todd-tracerlab/PTHSonde/Dashboard/tracerlab.png

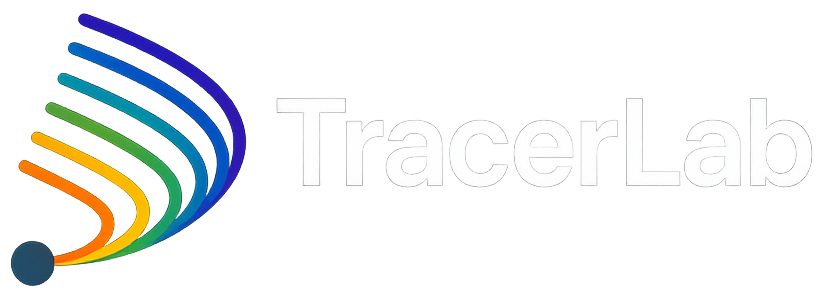
Dashboard/tracerlab.png
