todd-tracerlab/PTHSonde/Dashboard/truck.png

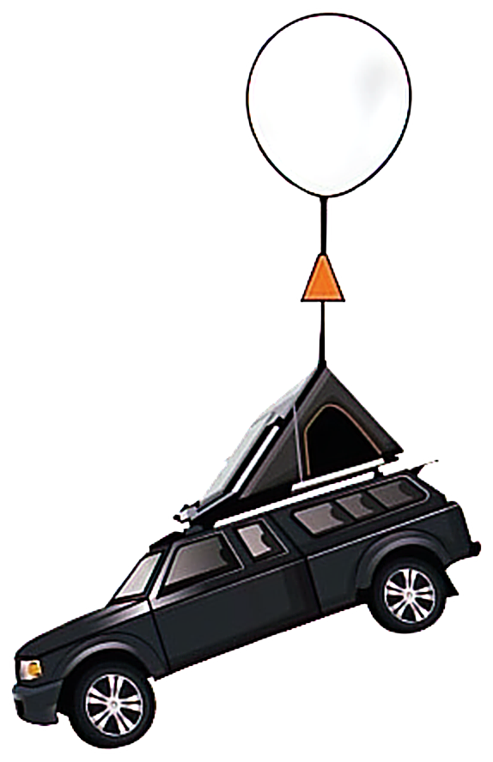
Dashboard/truck.png
