todd-tracerlab/PTHSonde/latax/3rd tie sonde to flight line.jpeg

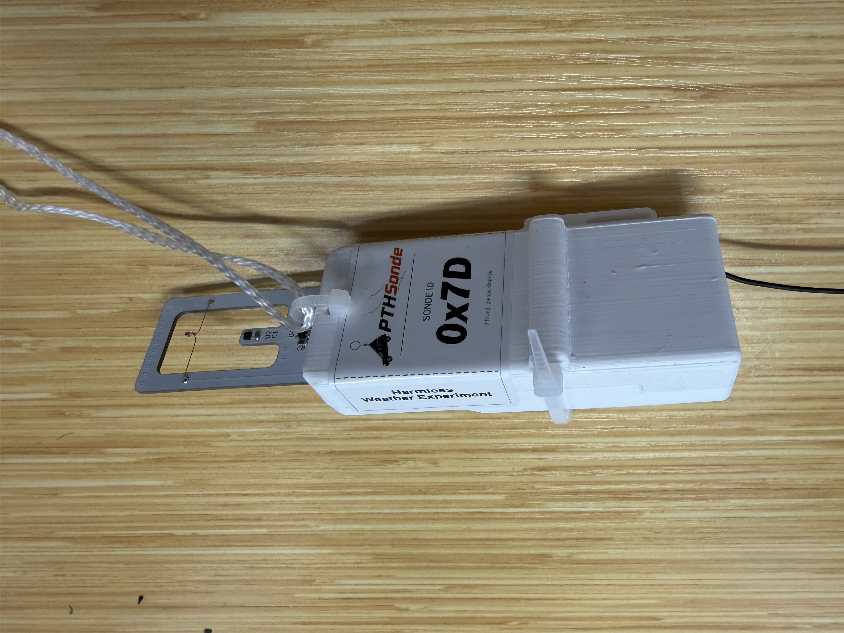
latax/3rd tie sonde to flight line.jpeg
