todd-tracerlab/PTHSonde/latax/first opening the battery door and inserting battery.jpeg

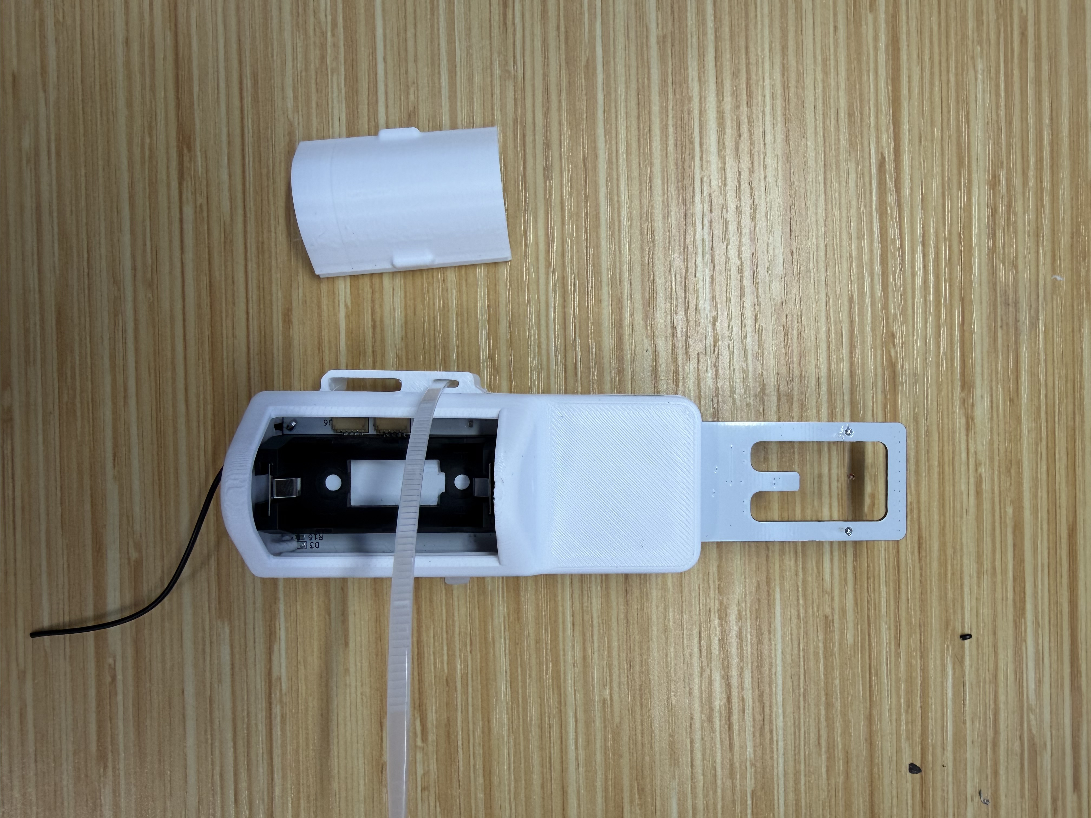
latax/first opening the battery door and inserting battery.jpeg
