todd-tracerlab/PTHSonde/latax/second zip tie the outer battery door closed.jpeg

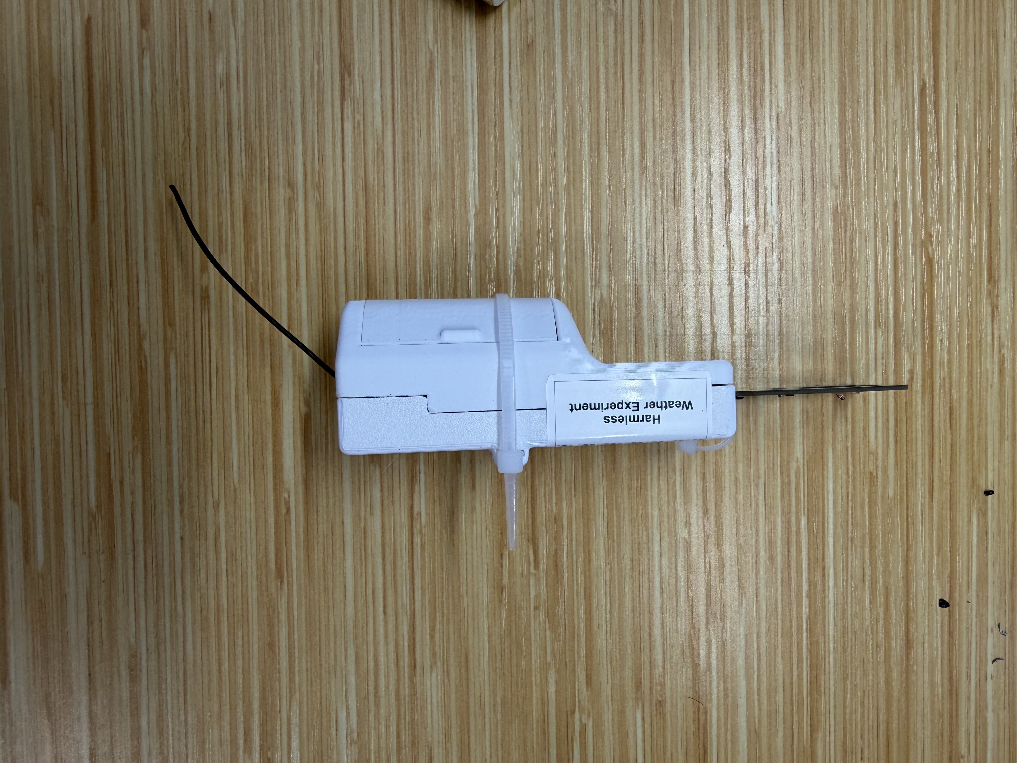
latax/second zip tie the outer battery door closed.jpeg
