todd-tracerlab/PTHSonde/(commit log)

2026-07-07 PTHSonde: firmware, dashboard, and processor + docs
    Complete open radiosonde telemetry system:
    - SondeTransmitter/ flight firmware (ESP32-C3): sensors, GPS, LoRa TX
    - GroundReceiver/ ground-station firmware: LoRa RX -> CSV over USB
    - Dashboard/ single-file HTML ground-station UI
    - processor/ pywebview app: Flask + serial + SHARPpy render pipeline
    - docs/ hardware map, firmware guide, dashboard guide
    GPS is held in L86 Balloon mode (80 km) with ACK verification; the sounding
    pipeline trims launch-pad thermal-soak so lifted indices are physical.
2026-07-09 Dashboard + processing refinements
    Dashboard:
    - Time Series moved into the right-panel toggle as a 2x3 grid
    (temp/dewpoint/wind on the left; ascent rate/altitude/humidity on the right;
    altitude shows both barometric and GPS traces)
    - Skew-T, hodograph and profiles are ascent-only (descent no longer plotted)
    - System Health: RSSI/SNR replotted as signal-vs-noise on one dBm axis (the gap
    IS the SNR); battery shows volts only; removed subtitle clutter; larger, higher-
    contrast axis labels
    - Map: plain gridded track map offline, real OSM tiles online, switching live
    without reopening; toasts on switch; GFS prediction warns when offline
    (also fixes the fallback <canvas> being stuck at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
    [sonde_server.py]
2026-07-09 Fix SHARPpy image: in-app zoom/pan lightbox instead of window.open(blob)
    Clicking the sounding did window.open(URL.createObjectURL(blob)), which WebView2
    can't navigate to -> Windows 'can't open this blob' popup in the packaged app, and
    there was no way to zoom into the panel's small text. Replaced with a DOM lightbox:
    click to open, scroll to zoom, drag to pan, double-click to fit, Esc/backdrop to close.
2026-07-09 Branding: TracerLab sidebar logo, PTHSonde wordmark, cropped truck, app icon
    - Add the TracerLab company logo pinned to the bottom of the sidebar (fills the
    previously-blank space; sits on a subtle dark card so it reads in both themes)
    - Replace the header text with a dedicated PTHSonde 'Ground Station' wordmark PNG
    - Crop the flying-truck art to content, upscale 2x + sharpen, and show it larger
    in a taller header (with a soft drop shadow for definition)
    - Use the flying-truck as the packaged app's Windows icon (PTHSonde.spec)
2026-07-09 Rebrand header + theme-aware top bar, orange accent, plot & UX improvements
    - New PTHSonde brand logo (truck + skew-T sounding) in the header; theme-aware
    top bar that swaps to light-ink logo + TracerLab in dark mode
    - TracerLab moved to the top-right; Light/Dark toggle moved into the top bar;
    default theme back to dark; top-bar elements spread across the width
    - Orange accent throughout (was blue); header 'Press Alt' (barometric)
    - Larger sidebar telemetry; ascent-only Skew-T; dual km altitude axis on the
    Skew-T and the three profile plots; larger/bolder axis labels + hPa/km captions
    - 'Import Past Flight' (renamed) no longer triggers the sonde-detected popup
    Processor:
    -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
    [sonde_server.py]
2026-07-10 SHARPpy panel: stamp launch date/UTC time + starting lat-lon
    Under the PTHSonde logo, caption the first solid GPS fix (real fix + >=5 sats,
    skipping cold-start glitches): date from the flight folder, UTC time from the
    GPS, and the starting lat/lon.
    [sonde_server.py]
2026-07-10 Firmware: proto v4 -- ground-derived wind, 0.1% RH, station ID, USB STATUS
    Telemetry protocol bumped 2 -> 4 (both boards must be reflashed together):
    - Wind off the air: drop wind speed + direction from the packet; the ground
    receiver now derives them from successive downlinked GPS fixes (velocity =
    d(pos)/dt, EMA-smoothed; met direction = travel bearing + 180). Fills the same
    speed_mps/wind_deg/v_wind CSV columns, so the recorder, data.csv, SHARPpy, and
    dashboard are unchanged. Packet 43 -> 39 bytes.
    - RH precision: sht_rh_x2 (uint8, 0.5%) -> sht_rh_x10 (uint16, 0.1%) to match
    the SHT41's actual repeatability. CSV already prints %.1f, no downstream change.
    - Ground-station ID: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
    [CsvOutput.cpp, GroundReceiver.ino, SondeTransmitter.ino, TelemetryPacket.h]
2026-07-12 GPS: bulletproof balloon mode + NaN stale position on fix loss
    The 2026-07-12 flight capped at ~11 km (the 10 km Normal-mode ceiling) even
    though the L86 ACKs balloon mode (fr=3) on the bench. Evidence: sats 15->0 in
    one step, GPS clock kept ticking (module alive, not cold, not reset-at-11km),
    never recovered. Per the Quectel Lx protocol spec, Balloon=80 km / all other
    modes=10 km, so the module was effectively in Normal mode in flight -- PMTK886 is
    volatile and had reverted. Harden the firmware to keep it in balloon mode:
    - Never relax the re-assert: send PMTK886,3 every ~4 s for the whole flight
    (was dropping to a 15 s keep-alive after the first ACK).
    - Detect L86 restarts (PMTK010/PMTK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
    [CsvOutput.cpp, GpsManager.cpp, GpsManager.h, SondeTransmitter.ino, TelemetryPacket.h, sonde_server.py]
2026-07-13 Dashboard: fix bogus surface parcel + phantom CAPE + stale-code launcher
    Sounding analysis was producing nonsense CAPE (e.g. 3128 J/kg with LI +13 and no
    LFC on a capped marine inversion). Root causes:
    - Surface parcel: robust_surface scanned the WHOLE flight for the highest pressure
    (so a cooler/lower landing hijacked the surface) and medianed a noisy near-ground
    thermistor. Redefined it the way it should be: the surface is the first sample
    actually CLIMBING (barometric ascent rate > 2 m/s), 5-point averaged -- skips the
    pre-launch pad noise (soak / equilibration) and the descent entirely. Also feed
    the surface from the RAW launch rows, not the soak-trimmed profile.
    - Phantom CA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
    [sharppy_render.py, sonde_server.py]
2026-07-13 Manual: cover art, header, inventory tracker, spec-table firmware match
    - Severe-weather cover backdrop (public-domain NOAA cumulonimbus) filled edge-to-edge;
    hero sensor window made transparent so the cloud shows behind the thermistor; logo
    balloon filled white; orange subtitle so it reads over the cloud.
    - Header: larger PTHSonde (left) and TracerLab (right) logos, now on every page but the title.
    - Chapter 5 reorganised (balloon choice + fill table + Fill Calculator in one section);
    flight-train diagram pinned; parachute drawn as a triangle.
    - New appendix: Inventory & stock tracker (sonde / balloon / lift-gas), one table per page.
    - Measurement spec table reconciled with firmware: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
2026-07-14 Manual: field quick-start card + spec/wording corrections
    - New print-and-cut field quick-start card (3.62x6.6 in) under the Quick reference:
    spec chips, Kaymont fill table, 9-step checklist, numbered prep photos
    (battery / zip-tie / flight line) and the flight-train diagram.
    - Spec table corrected to match the hardware: pressure altitude range 0-31 km
    (MS5611 baro range, not the GPS envelope); wind relabelled GPS-derived, 0-100 m/s.
    - Removed marketing/implementation copy: GPS-ceiling claim, "firmware already flashed"
    note, ESP32 / 3D-printed mentions, and sonde-on-USB references.
2026-07-15 Dashboard: shared time-series x-axis + GPS-anchored geopotential altitude
    - Time-series plots now share one x-axis [t0, tN], so the wind plot advances with
    the others before GPS lock and its data lands at the correct shared time position
    once locked (instead of restarting from the left edge).
    - Altitude is now true geopotential height: hypsometric integration of the sonde's
    own measured (virtual) temperature, anchored to the launch altitude (pad-averaged
    GPS, or a manual override in Settings). Replaces the plain ISA formula, which ran
    ~500 m low at altitude. Falls back to ISA when no GPS anchor exists, so it still
    works above the GPS ceiling.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
2026-07-15 Dashboard: reject partial CSV headers so they can't corrupt the column map
    A header line split across two serial reads still starts with "rx_ms", so it was
    accepted as complete and rebuilt colMap missing the trailing columns -- every v_*
    sensor flag plus sonde_ch. Result: all sensor dots red and no pairing popup while
    packets kept streaming. Now a header is only trusted if it has the full column
    count and the trailing columns (v_ms, sonde_ch, crc_ok); otherwise the known-good
    map is kept and a warning is logged. Applied to both the live and import paths.
2026-07-15 Firmware: sensor init self-heal + kill stale/false-valid telemetry
    - Sensors.cpp: settle delay + boot retries + in-loop self-heal for SHT41/MS5611.
    A cold-boot I2C NACK no longer strands a sensor red for the whole flight -- it
    re-begins on its own (and re-inits after N wedged reads), coming green in ~1 s.
    - BatteryMonitor.cpp (INA219): same self-heal, and treat 0 V / NaN as a failed
    read so a wedged monitor stops shipping valid 0 V / 0 mA.
    - SondeTransmitter.ino: gate TF_VALID_MS on a per-window freshness flag so a dead
    MS5611 stops shipping the frozen median as valid; add LoRa self-heal that retries
    the E22 config if it never ACKed at boot.
    - GpsManager.cpp: gate the fix on positi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
    [BatteryMonitor.cpp, GpsManager.cpp, Sensors.cpp, SondeTransmitter.ino, TelemetryPacket.h]
2026-07-15 Dashboard: lock live telemetry to the paired sonde + unpair on flight end
    Once paired to a sonde ID, drop every packet from any other sonde on the
    air (e.g. a bench unit powered up nearby) so it can't be ingested, plotted,
    recorded, or re-paired to. On Stop Flight, clear the pairing so the next
    sonde can be paired for the next flight.
2026-07-15 Dashboard: prompt to pair the next sonde after a flight ends
    v1.4.5 unpaired on Stop Flight but the pair prompt was still gated by
    flightDone, which stays true until Clear -- so no newly powered sonde could
    prompt to pair after a flight. Split "finished live flight" from "reviewing a
    replayed import" with a dedicated viewingImport flag: a finished live flight
    now keeps prompting for the next sonde, while imports stay locked.
    - maybeShowPair no longer blocks on flightDone (only on viewingImport)
    - Stop Flight dismisses the just-flown ID so it won't instantly re-prompt while
    still transmitting during recovery; a DIFFERENT sonde still prompts
    - Pairing a new sonde while a finished flight is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
2026-07-15 README: rewrite Key features as benefit-led product copy
    The old bullets read like engineering rationale (mechanism, lapse-rate math,
    receiver part numbers). Recast each as a crisp, benefit-first feature line and
    add reusable-payload as a feature.
2026-07-18 v1.5.0: Analysis ops panel + custom surface, self-contained SHARPpy, Open Past Flight, selectable basemaps
    Analysis tab
    - New operational-products panel with color-scale ranges: severe weather
    (SCP, STP, SHIP, DCAPE, MLCAPE/CIN), moisture & deep convection (PWAT,
    K, Total Totals, lapse rates), fire weather (Haines, Fosberg, ventilation),
    and icing/freezing levels. Replaces the raw SHARPpy indices table.
    - Surface card shows the P/T/RH/wind actually used; "Set custom surface"
    lets you edit surface T/RH/wind and start the sounding at a chosen
    pressure, then re-process. Custom runs write data_CS.csv and never touch
    the raw data.csv.
    Self-contained SHARPpy (the app now ships the rea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
    [sonde_server.py]
2026-07-18 Map: make flight prediction lines readable on any basemap
    The predicted-path and baseline lines were thin (weight 1.5-2), half-
    transparent, and gray, so they vanished on the satellite and dark basemaps.
    Redraw each as a bold bright core over a dark casing (halo), matching the
    flight-track treatment: cyan ascent / orange descent at weight 4, and the
    frozen GFS baseline as a lighter dotted reference. Adds a casedLine() helper.
    Claude-Session: https://claude.ai/code/session_01CWyjfbLumQnRCPRwnst5tQ
