todd-tracerlab/PTHSonde/latax/gcs.jpeg

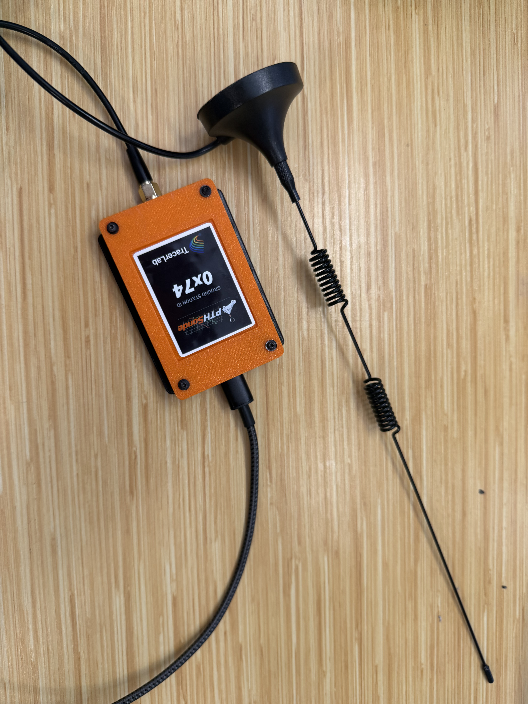
latax/gcs.jpeg
